ayrtonmo/kubibot/screen/README.md

Módulo para la muestra de emociones en Kubibot. Pensado para ser mostrado en una pantalla conectada al Raspberry PI 5

**Esto no fue incluido en el proyecto final.**
