ayrtonmo/kubibot/docs/frontmatter/titlepage.tex

\begin{titlepage}
\thispagestyle{empty}
\centering
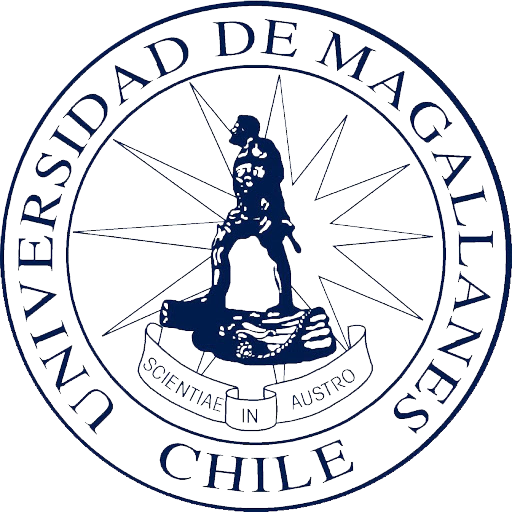
[picture p11: docs/Fig/logo_umag.png]

\hspace{3.5cm}
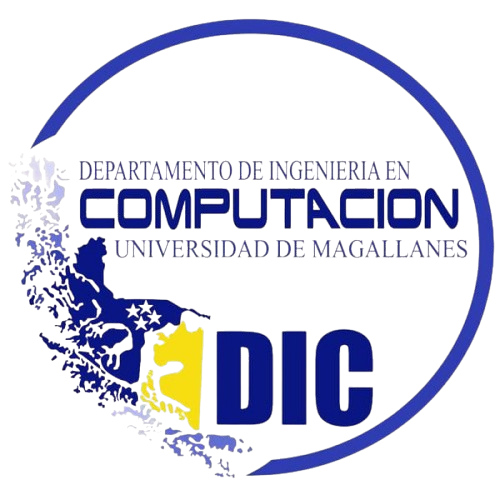
[picture p12: docs/Fig/logo_depto.png]

\vspace{1.5cm}

{\large \UnivLine\par}

\vspace{2cm}

{\LARGE\bfseries
\tituloInforme\par}

\vspace{1.5cm}

{\large \AuthorName\par}
{\large \nombreCarrera\par}

\vspace{2cm}

\vspace{1cm}

{\large Docente guía: \profesorRamo\par}
{\large Curso: \nombreRamo \par}

\vfill

{\large \GradYear\par}

\end{titlepage}
