ayrtonmo/kubibot/docs/Fig/Sensor_diagrama.png

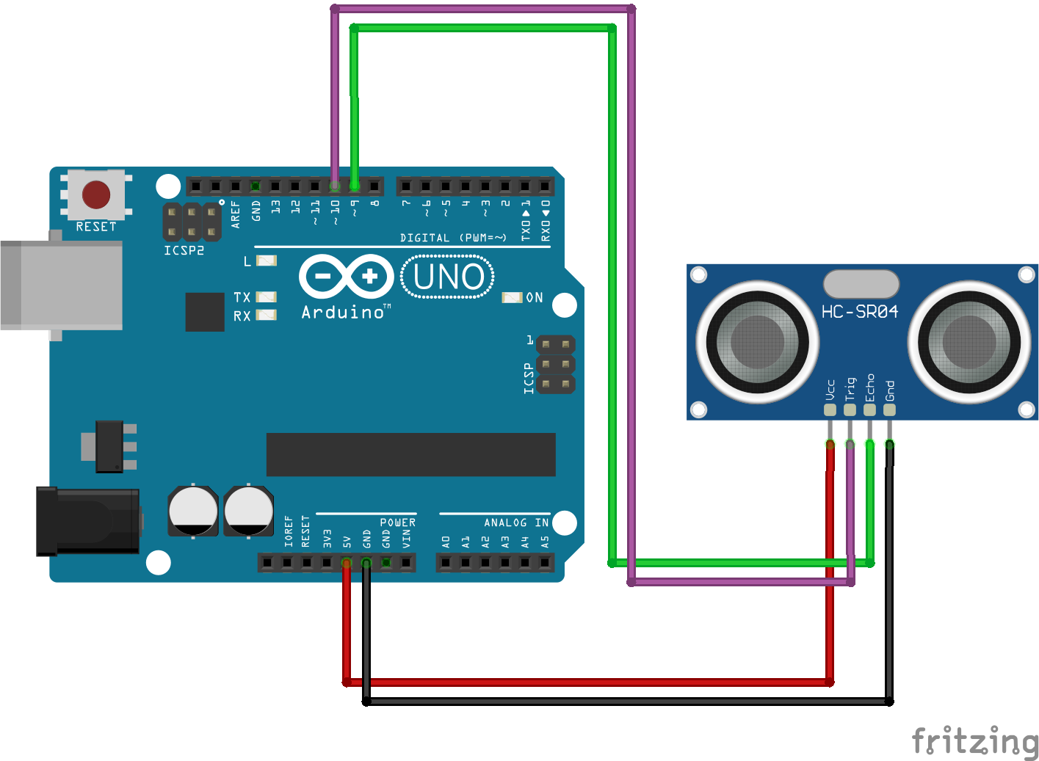
docs/Fig/Sensor_diagrama.png
