ayrtonmo/kubibot/docs/Fig/Servo_diagrama.png

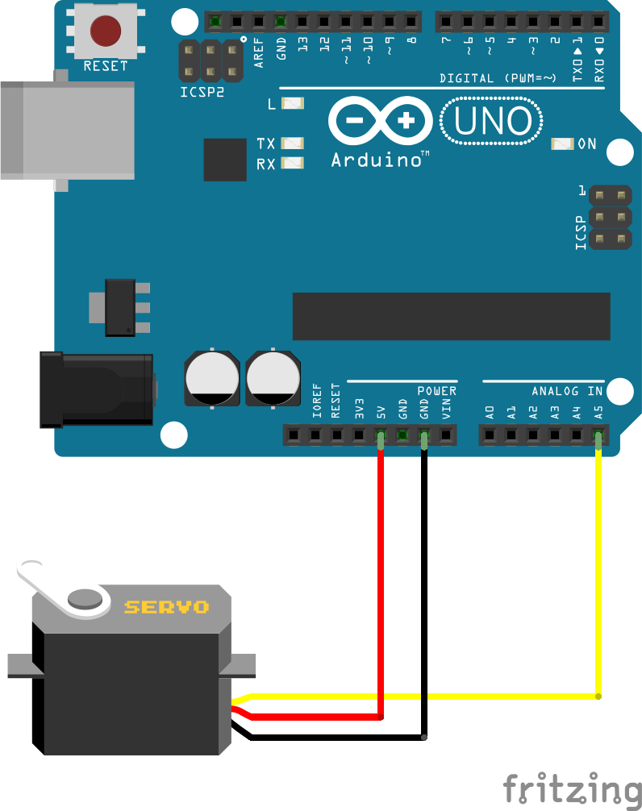
docs/Fig/Servo_diagrama.png
