ayrtonmo/kubibot/docs/Fig/diagrama_fin.pdf

## STT

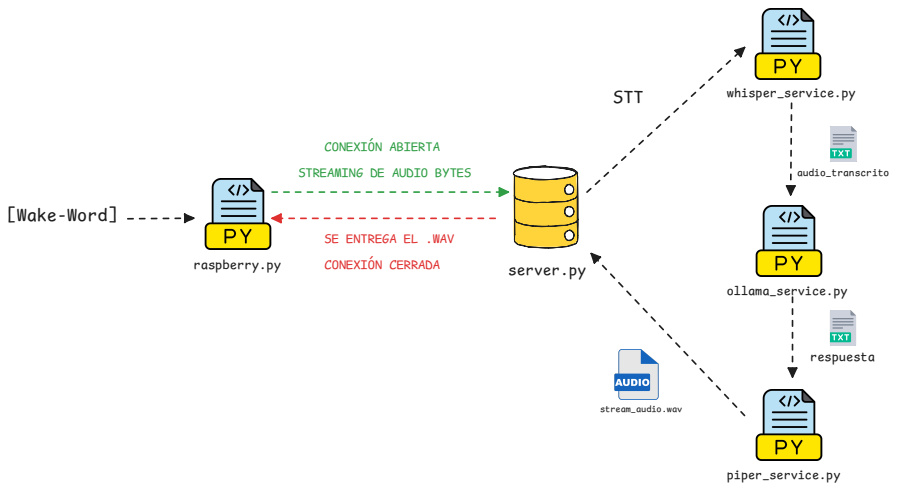
[picture p27: page 1]
server.py; raspberry.py; whisper_service.py; ollama_service.py; [Wake-Word]; CONEXIÓN ABIERTA; piper_service.py; audio_transcrito; respuesta; stream_audio.wav

STREAMING DE AUDIO BYTES

SE ENTREGA EL .WAV
CONEXIÓN CERRADA
