ayrtonmo/kubibot/docs/Fig/esquema_motor.pdf

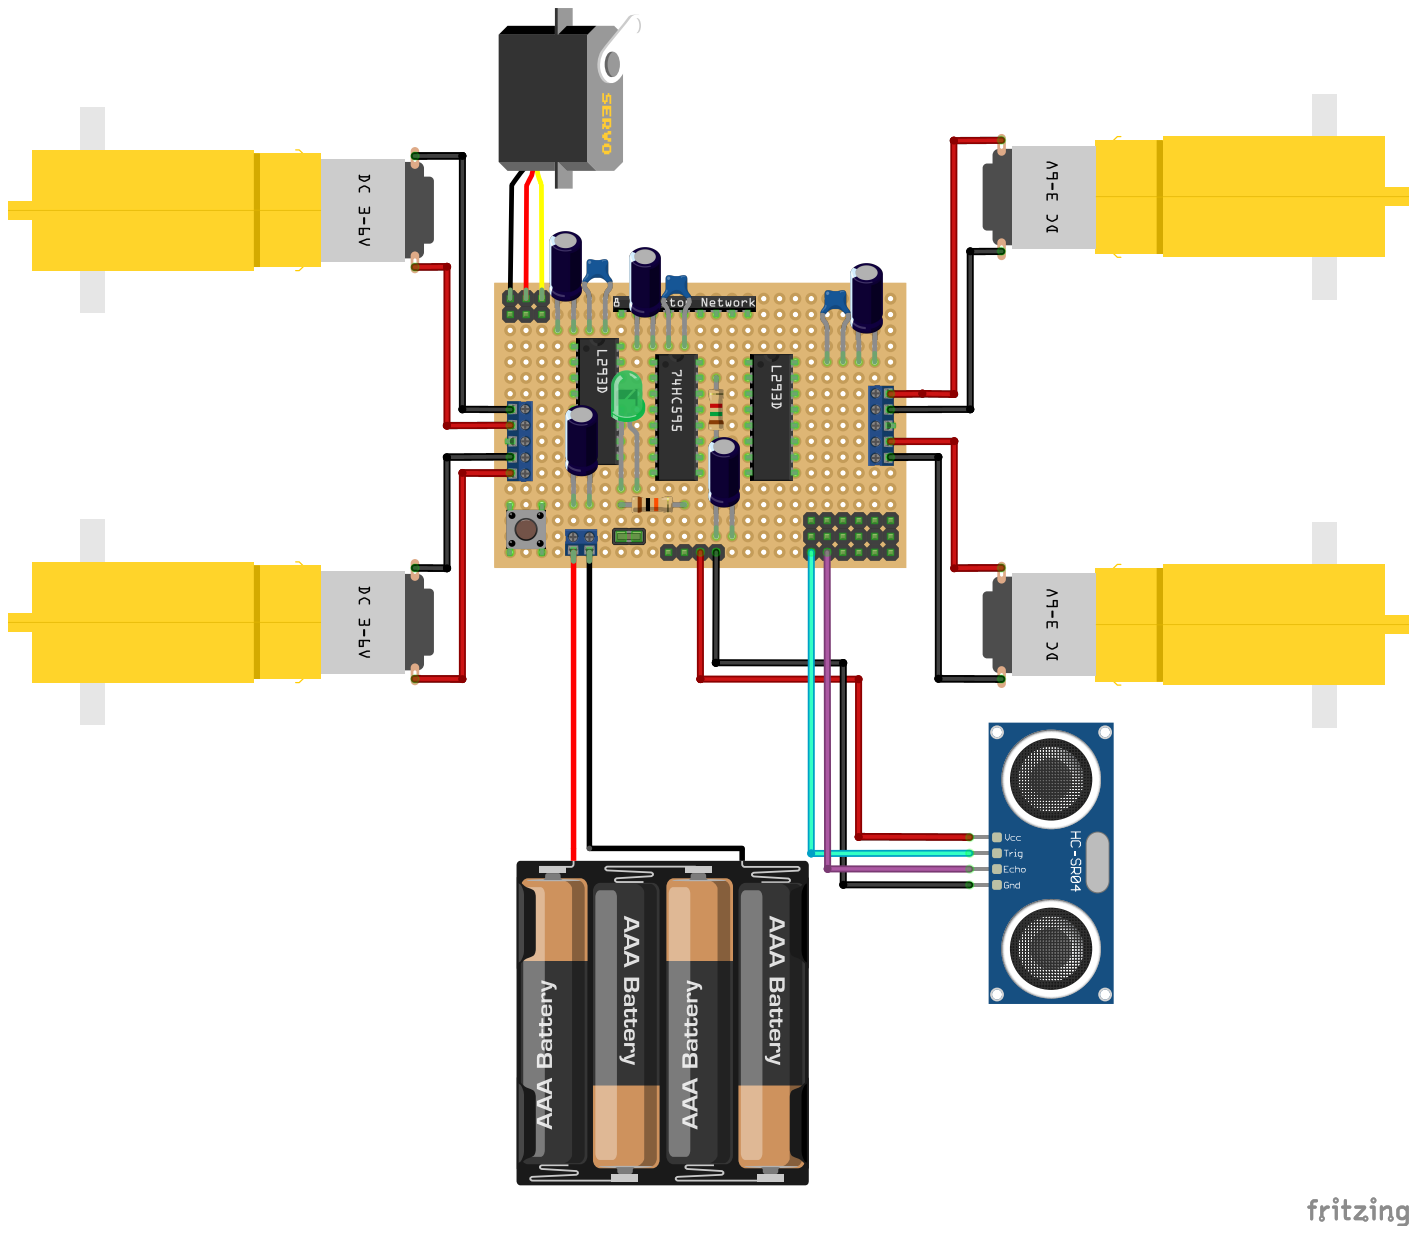
[picture p28: page 1]
