ayrtonmo/kubibot/docs/Fig/diagrama_api.pdf

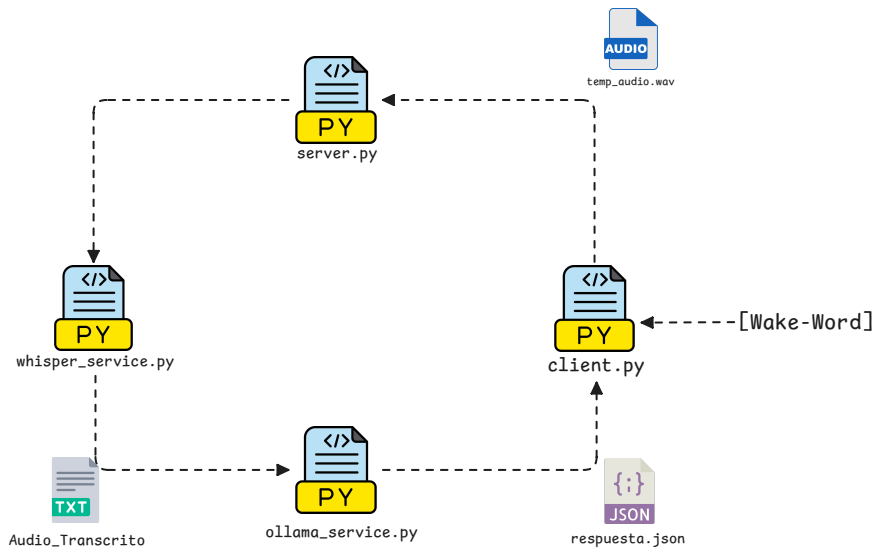
[picture p29: page 1]
server.py; temp_audio.wav; [Wake-Word]; whisper_service.py; ollama_service.py; Audio_Transcrito; client.py; respuesta.json
