ayrtonmo/kubibot/(commit log)

2025-10-01 add: Se comienza a trabajar con el movimiento y deteccion de obstaculos
2025-10-01 add: Se empieza a configurar el modelo para la IA de kubibot
2025-10-03 add: Detalles en el codigo
2025-10-25 add: Se comenzo a crear la API de requests
2025-11-16 add: Se refactorizo el codigo anhadiendo la clase ArduinoRobot
2025-11-16 feat: giro arduino
2025-11-16 add: Se implementa una primera version de lo que es la API y el codigo para el cliente
2025-11-16 doc: Se cambiaron algunso nombres de variables y documentacion
2025-11-16 base: se actualizo gitignore y se cambio la estructura de archiv
2025-11-20 add: Se actualizo la configuracion de kubibot
2025-11-20 add: se anhadio historial de mensajes para mejorar la UX
2025-11-21 base:Se actualizo carpeta de para borrar su cache
2025-11-27 add: mov servo y selección de camino
2025-11-27 fix: pin servo arreglado
    [movement.ino]
2025-11-30 add: Cambios en movimiento arduino, especificamente en servomotor
2025-12-01 add: Se anhadieron seriales para depuracion y se arreglo caso reversa
    [movement.ino]
2025-12-02 doc: Se empezo a redactar el README
2025-12-03 fix: Se corrigio pequenho error de tieo
    [client.py]
2025-12-04 add: Se anhadio autenticacion via token y se actualizo el envexample
2025-12-04 doc: Se avanzo el reporte tecnico
2025-12-05 refac: Se refactorizo el codigo para utilizar websockets
2025-12-09 fix: cambio pines arduino para driver motor nuevo
    [movement.ino]
2025-12-12 add: archivos para raspberry
2025-12-12 add: Se modifico el gitignore para anhadir documentacion
2025-12-12 add: Se modifico el servidor para anhadir piper
2025-12-17 add: Se refactorizo el codigo para trabajar con shield HW130
2025-12-18 add: Se hicieron cambios en la interfaz del asistente (audio inicio, audio final)
2025-12-18 docs: estructura de archivos y documentación arduino
2025-12-18 refac: Reestructuración de archivos
2025-12-18 doc: Se actualizo el README
2025-12-19 add: Se separo el TTS en piper_service para que el server este mas limpio
2025-12-28 add: arduino al recibir 'Q' o 'R' del serial se detiene o sigue según corresponda
2025-12-28 add: Se anhadio conexion serial con arduino
2025-12-28 add: Se anhaden prints
2025-12-29 add: Se detalle en manejo de cooldown
2025-12-29 add: Se anhadieron medidad de seguridad, como watchdogs, reintentos de conexion y checkeos para las venv
2025-12-29 add: Se integro un HandShake entre el arduino y el raspberry para que asegurar funcionamiento correcto
    [arduino.ino, raspberry.py]
2025-12-29 add: Cambios en tiempos de arduino
2025-12-29 add: Se modifico el codigo arduino para que inicialice detenido
2025-12-29 doc: Se avanzo en el informe
2025-12-30 add: se corrigio detalle
    [raspberry.py]
2025-12-30 add: Commit para probar creacion de config.py
2025-12-30 add: Otro detalle de tipeo
2025-12-30 fix: Correccion detalle en llamada a propieda
    [raspberry.py]
2025-12-30 add: Se empezo a anhadir la configuracion de systemd
2026-01-08 docs: Se finalizo el reporte tecnico mas detalles
